azonenberg/sky130-validation/README.md

# sky130 validation stuff

Right now focusing on OpenRAM bringup chip.
