azonenberg/sky130-validation/or1/data/vmap/images/large/die4_dualport_chilled.png

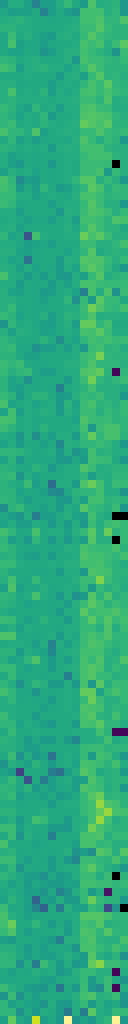
or1/data/vmap/images/large/die4_dualport_chilled.png
