azonenberg/sky130-validation/or1/data/vmap/images/large/die4_dualport_heated.png

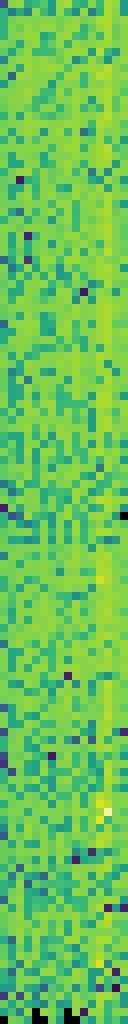
or1/data/vmap/images/large/die4_dualport_heated.png
