azonenberg/sky130-validation/or1/data/vmap/images/large/die5_dualport_ambient.png

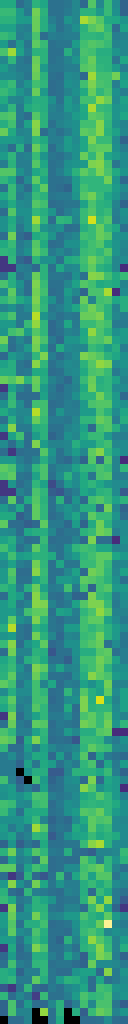
or1/data/vmap/images/large/die5_dualport_ambient.png
