azonenberg/sky130-validation/or1/data/vmap/images/large/die5_singleport_heated.png

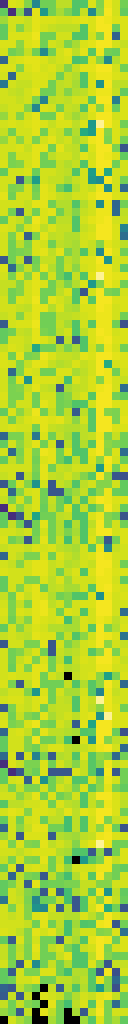
or1/data/vmap/images/large/die5_singleport_heated.png
