azonenberg/sky130-validation/or1/boards/brain/brain.kicad_pcb

## KiCad design or1/boards/brain/brain.kicad_pcb (2021-11-06)

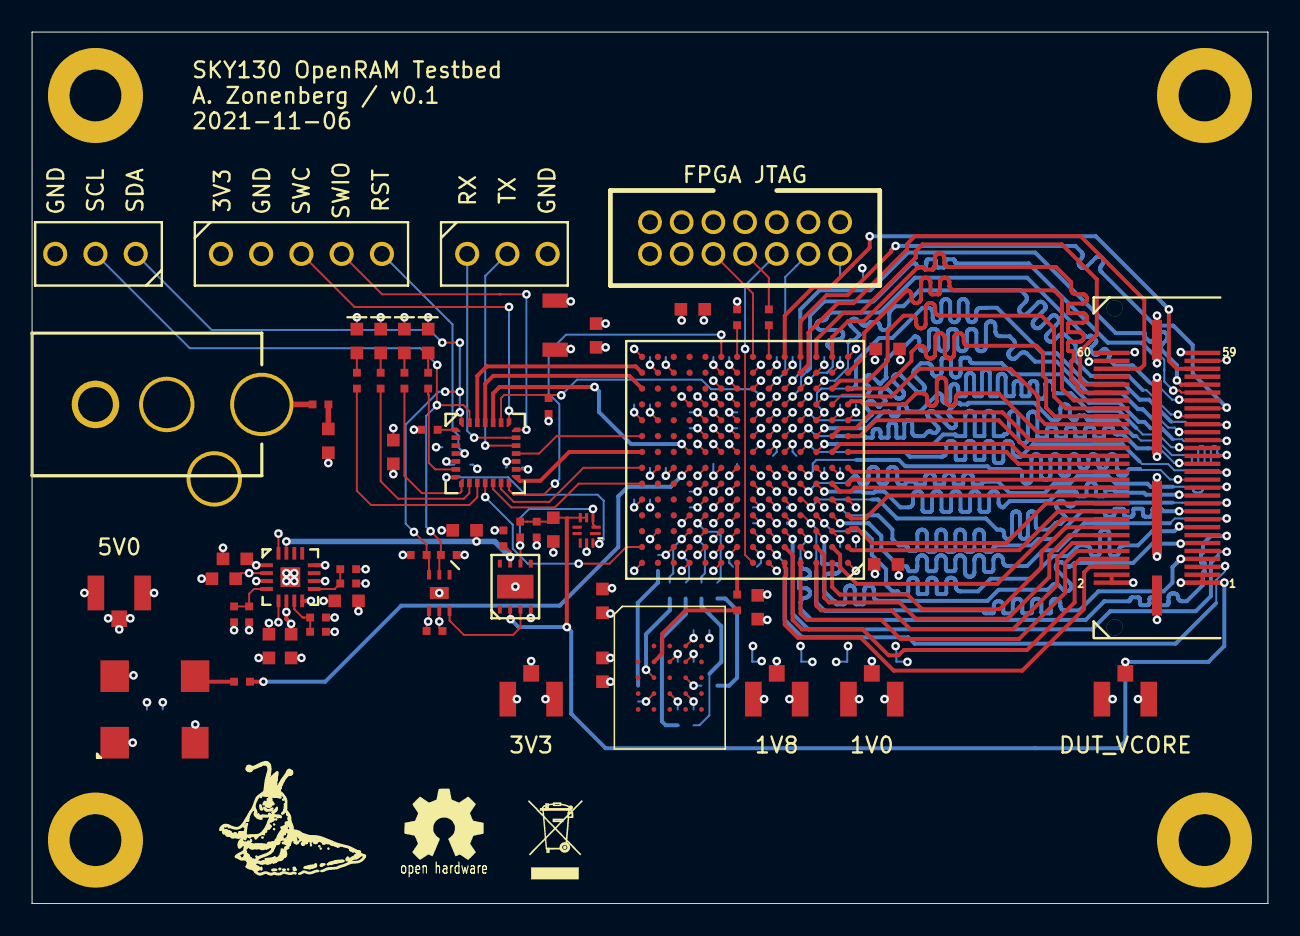
[picture p13: board brain.kicad_pcb from above]

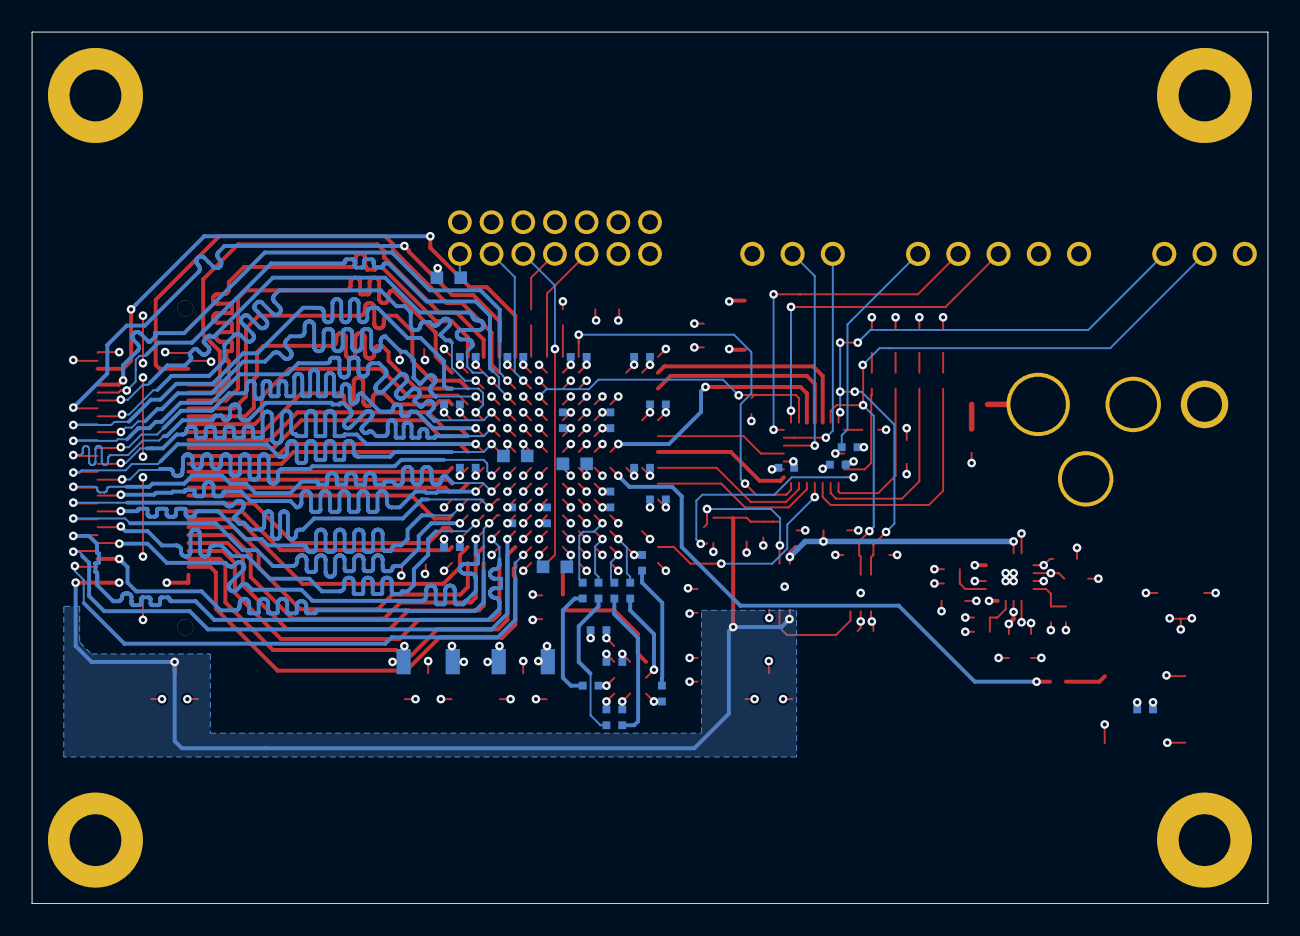
[picture p14: board brain.kicad_pcb from below]

Board: 4 copper layers, 78.0 x 55.0 mm, 103 parts (36 on the bottom side), 115 nets.

Parts:
C1, C4: 100 uF; EIA_1206_CAP_NOSILK
C2, C5, C6, C7, C9, C10, C11, C12, C13, C14, C15, C17, C18, C19, C20, C34, C37, C41, C43: 4.7 uF; EIA_0603_CAP_NOSILK
C3: 47 uF; EIA_1206_CAP_NOSILK
C8, C16, C21, C22, C23, C24, C25, C26, C27, C28, C29, C30, C31, C32, C33, C35, C36, C38, C40, C42, C44, C45: 0.47 uF; EIA_0402_CAP_NOSILK
C39: 0.1 uF; EIA_0402_CAP_NOSILK
D1, D2, D3, D4: GREEN; EIA_0603_LED
F1: 1A; EIA_0402_RES_NOSILK
FB1: 600R @ 100 MHz; EIA_0603_INDUCTOR_NOSILK
J1: XILINX_JTAG; XILINX_JTAG_PTH_MOLEX_0878311420
J2: BARREL_JACK; CONN_CUI_PJ-058BH_HIPWR_BARREL_NOSLOT
J3, J6: Conn_01x03; CONN_HEADER_2.54MM_1x3
J4: Conn_01x05; CONN_HEADER_2.54MM_1x5
J5: CONN_SKY130_TEST_HOST; CONN_SAMTEC_QSH-030-01-L-D-A
MH1, MH2, MH3, MH4: SCREWHOLE_4_40; MECHANICAL_CLEARANCEHOLE_4_40
R1, R2: 100K; EIA_0402_RES_NOSILK
R3: 130K; EIA_0402_RES_NOSILK
R4: 49.9K; EIA_0402_RES_NOSILK
R5: 187K; EIA_0402_RES_NOSILK
R6: 33K; EIA_0402_RES_NOSILK
R7, R8, R9, R10, R11, R14, R20, R21, R22, R23, R24, R29: 33; EIA_0402_RES_NOSILK
R12, R25: 10K; EIA_0402_RES_NOSILK
R13, R15, R17, R18: 1K; EIA_0402_RES_NOSILK
R16, R26, R27: 4.7k; EIA_0402_RES_NOSILK
R19: 4.7K; EIA_0402_RES_NOSILK
R28: 10 0.1%; EIA_0402_RES_NOSILK
TP1, TP2, TP3, TP4, TP5: U.FL; CONN_U.FL_TE_1909763-1
U1: STM32F031-QFN28; QFN_28_0.5MM_4x4MM_NOPAD
U2: XC7S15-1FTGB196C; BGA_196_15x15_FULLARRAY_1MM_FTGB196
U3: ADP323; QFN_16_0.5MM_3x3MM
U4: S25FL128SAGBHI300; BGA_24_6x8_DEPOP1_1MM
U5: DAC121C081-WSON; DFN_6_0.65MM_2.2x2.5MM_TI_NGF
U6: ISL24021IRT065Z-T7A‎; DFN_8_0.65MM_3x3MM
U7: INA216A2; QFN_10_0.4MM_1.4x1.8MM_TI_RSW
U8: CB3LV-3C-25M000000; OSCILLATOR_7.0x5.0

Connections:
/1V0: C1.1, C2.1, C6.1, C7.1, C8.1, C15.1, C21.1, C26.1, R1.1, TP4.1, U2.D6, U2.D8, U2.E5, U2.E7, U2.E9, U2.F6, U2.G5, U2.G9, U2.H6, U2.J5, U2.J9, U2.K6, U2.K8, U3.5
/1V8: C3.1, C9.1, C14.1, C16.1, C22.1, R3.1, TP2.1, U2.B8, U2.F8, U2.F10, U2.H10, U2.K10, U2.L9, U3.6
/3V3: C4.1, C10.1, C11.1, C12.1, C17.1, C18.1, C19.1, C20.1, C23.1, C24.1, C25.1, C27.1, C28.1, C29.1, C30.1, C31.1, C32.1, C33.1, C34.1, C35.1, C36.1, C37.1, C38.1, C40.1, C45.1, J1.2, J4.1, J5.57, J5.58, J5.59, J5.60, R5.1, R12.2, R16.1, R19.1, R26.1, R27.1, TP3.1, U1.5, U1.17, U2.B10, U2.G2, U2.G13, U2.K2, U2.K13, U2.M7, U2.N2, U2.N6, U2.N7, U2.N8, U2.N13, U3.8, U4.B4, U5.5, U8.1, U8.4
/DUT socket/ADDR0_0: J5.44, U2.M1
/DUT socket/ADDR0_1: J5.43, U2.M3
/DUT socket/ADDR0_2: J5.41, U2.K3
/DUT socket/ADDR0_3: J5.39, U2.L3
/DUT socket/ADDR0_4: J5.37, U2.K4
/DUT socket/ADDR0_5: J5.35, U2.J3
/DUT socket/ADDR0_6: J5.33, U2.J4
/DUT socket/ADDR0_7: J5.31, U2.H3
/DUT socket/ADDR1_0: J5.13, U2.C4
/DUT socket/ADDR1_1: J5.11, U2.C3
/DUT socket/ADDR1_2: J5.9, U2.C5
/DUT socket/ADDR1_3: J5.7, U2.D4
/DUT socket/ADDR1_4: J5.5, U2.B6
/DUT socket/ADDR1_5: J5.8, U2.B5
/DUT socket/ADDR1_6: J5.12, U2.A3
/DUT socket/ADDR1_7: J5.16, U2.A2
/DUT socket/CLK0: J5.45, U2.P4
/DUT socket/CLK1: J5.55, U2.P5
/DUT socket/CS0_N: J5.46, U2.M2
/DUT socket/CS1_N: J5.56, U2.N4
/DUT socket/DIN0_0: J5.40, U2.L1
/DUT socket/DIN0_1: J5.38, U2.J2
/DUT socket/DIN0_2: J5.32, U2.H1
/DUT socket/DIN0_3: J5.30, U2.G1
/DUT socket/DIN0_4: J5.26, U2.F2
/DUT socket/DIN0_5: J5.22, U2.C1
/DUT socket/DIN0_6: J5.18, U2.B2
/DUT socket/DIN0_7: J5.10, U2.A4
/DUT socket/DOUT0_0: J5.36, U2.J1
/DUT socket/DOUT0_1: J5.42, U2.L2
/DUT socket/DOUT0_2: J5.34, U2.H2
/DUT socket/DOUT0_3: J5.28, U2.F1
/DUT socket/DOUT0_4: J5.24, U2.D1
/DUT socket/DOUT0_5: J5.20, U2.B1
/DUT socket/DOUT0_6: J5.14, U2.B3
/DUT socket/DOUT0_7: J5.6, U2.A5
/DUT socket/DOUT1_0: J5.15, U2.D3
/DUT socket/DOUT1_1: J5.27, U2.G4
/DUT socket/DOUT1_2: J5.29, U2.H4
/DUT socket/DOUT1_3: J5.17, U2.D2
/DUT socket/DOUT1_4: J5.19, U2.E2
/DUT socket/DOUT1_5: J5.21, U2.E4
/DUT socket/DOUT1_6: J5.23, U2.F3
/DUT socket/DOUT1_7: J5.25, U2.F4
/DUT socket/GPIO0: J5.52, U2.P3
/DUT socket/WE0_N: J5.50, U2.P2
/DUT socket/WMASK0_0: J5.51, U2.M5
/DUT socket/WMASK0_1: J5.49, U2.L5
/DUT socket/WMASK0_2: J5.47, U2.M4
/DUT socket/WMASK0_3: J5.48, U2.N1
/DUT_VCORE: C43.1, C44.1, J5.1, J5.2, J5.3, J5.4, R28.1, TP5.1, U6.2, U7.4, U7.5
/DUT_VDD_ISENSE: U1.7, U7.10
/FLASH_CS_N: R11.2, U4.C2
/FLASH_DQ0: R7.2, R21.1
/FLASH_DQ1: R8.2, R22.1
/FLASH_DQ2: R9.2, R23.1
/FLASH_DQ3: R10.2, R24.1
/FLASH_RST_N: R12.1, U4.A4
/FLASH_SCK: R20.1, U4.B2
/FPGA_CLK_25MHZ: R29.1, U2.G11
/FPGA_DONE: U1.14, U2.P9
/FPGA_RST_N: R16.2, U1.23, U2.L7
/GND: C1.2, C2.2, C3.2, C4.2, C5.2, C6.2, C7.2, C8.2, C9.2, C10.2, C11.2, C12.2, C13.2, C14.2, C15.2, C16.2, C17.2, C18.2, C19.2, C20.2, C21.2, C22.2, C23.2, C24.2, C25.2, C26.2, C27.2, C28.2, C29.2, C30.2, C31.2, C32.2, C33.2, C34.2, C35.2, C36.2, C37.2, C38.2, C39.2, C40.2, C41.2, C42.2, C43.2, C44.2, C45.2, D1.1, D2.1, D3.1, D4.1, J1.3, J1.5, J1.7, J1.9, J1.11, J2.2, J3.3, J4.2, J5.GND, J6.3, R2.1, R4.1, R6.1, R25.2, TP1.2, TP2.2, TP3.2, TP4.2, TP5.2, U1.16, U2.A1, U2.A6, U2.A9, U2.A11, U2.A14, U2.B4, U2.B7, U2.B9, U2.C2, U2.C6, U2.C7, U2.C8, U2.C9, U2.C13, U2.D5, U2.D7, U2.D9, U2.D11, U2.E1, U2.E3, U2.E6, U2.E8, U2.E10, U2.E14, U2.F5, U2.F7, U2.F9, U2.G3, U2.G6, U2.G7, U2.G8, U2.G10, U2.G12, U2.H5, U2.H7, U2.H8, U2.H9, U2.J6, U2.J7, U2.J8, U2.J10, U2.K1, U2.K5, U2.K7, U2.K9, U2.K14, U2.L4, U2.L6, U2.L8, U2.L10, U2.L11, U2.M8, U2.M9, U2.N3, U2.N5, U2.N9, U2.N12, U2.P1, U2.P14, U3.12, U3.PAD, U4.B3, U5.4, U5.PAD, U6.4, U6.PAD, U7.9, U8.2
/I2C_SCL: J6.2, R26.2, U1.27, U5.2
/I2C_SDA: J6.1, R27.2, U1.28, U5.3
/JTAG_TCK: J1.6, U2.A7
/JTAG_TDI: J1.10, U2.P7
/JTAG_TDO: J1.8, R14.2
/JTAG_TMS: J1.4, U2.M6
/MCU_GPIO0: U1.12, U2.F14
/MCU_GPIO1: U1.13, U2.G14
/MCU_GPIO2: U1.18, U2.J14
/MCU_GPIO3: U1.11, U2.B14
/MCU_LED0: R13.2, U1.10
/MCU_LED1: R15.2, U1.9
/MCU_LED2: R17.2, U1.8
/MCU_LED3: R18.2, U1.6
/MCU_RST_N: C39.1, J4.5, U1.4
/MCU_SPI_CS_N: U1.15, U2.H14
/MCU_SPI_SCK: U1.24, U2.H11
/MCU_SPI_SI: U1.26, U2.N14
/MCU_SPI_SO: U1.25, U2.M14
/Power supply/5V0: C5.1, C13.1, C41.1, C42.1, FB1.2, TP1.1, U3.1, U3.2, U3.3, U3.10, U3.15, U3.16, U6.7
/Power supply/DAC_VOUT: U5.6, U6.3
/Power supply/DUT_VDD_RAW: R28.2, U6.6, U7.2, U7.3
/Power supply/MCU_BOOT0: R25.1, U1.1
/SWCLK: J4.3, U1.22
/SWDIO: J4.4, U1.21
/UART_RX: J3.1, U1.20
/UART_TX: J3.2, U1.19
unnamed: D1.2, R13.1
unnamed: D2.2, R15.1
unnamed: D3.2, R17.1
unnamed: D4.2, R18.1
unnamed: F1.1, J2.1
unnamed: F1.2, FB1.1
unnamed: R1.2, R2.2, U3.4
unnamed: R3.2, R4.2, U3.7
unnamed: R5.2, R6.2, U3.9
unnamed: R7.1, U2.B11
unnamed: R8.1, U2.B12
unnamed: R9.1, U2.D10
unnamed: R10.1, U2.C10
unnamed: R11.1, U2.C11
unnamed: R14.1, U2.P6
unnamed: R19.2, U2.P8
unnamed: R20.2, U2.A8
unnamed: R21.2, U4.D3
unnamed: R22.2, U4.D2
unnamed: R23.2, U4.C4
unnamed: R24.2, U4.D4
unnamed: R29.2, U8.3
