azonenberg/sky130-validation/or1/boards/breakout/breakout.kicad_pcb

## KiCad design or1/boards/breakout/breakout.kicad_pcb (2021-11-06)

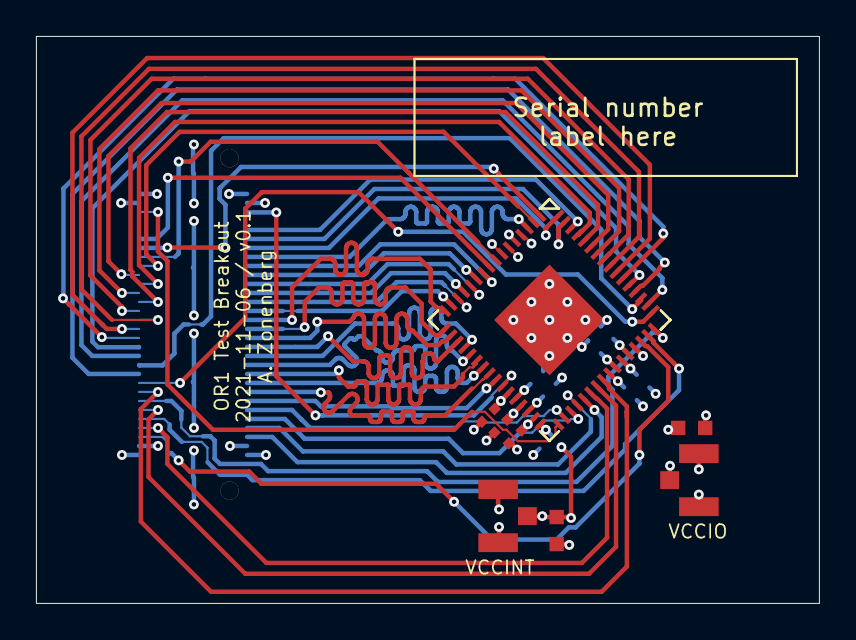
[picture p15: board breakout.kicad_pcb from above]

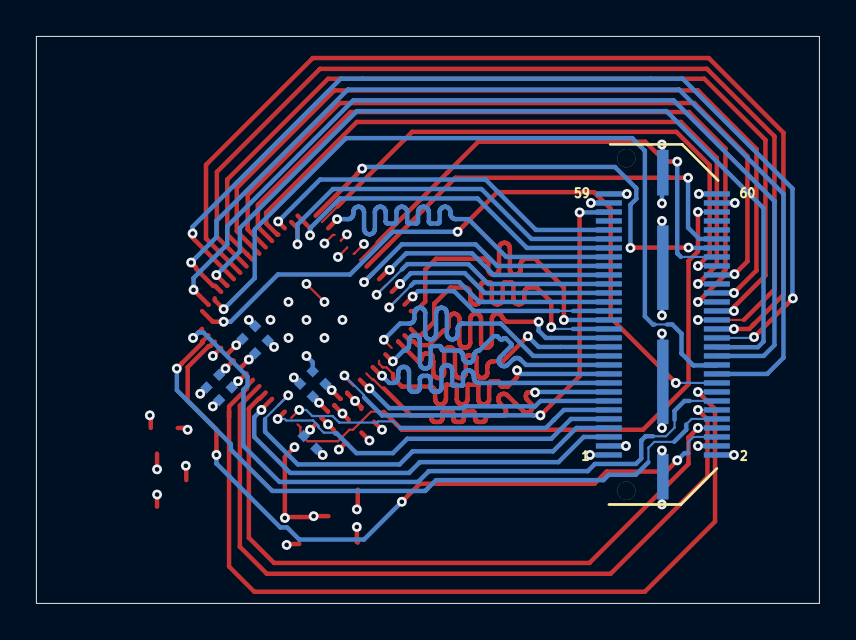
[picture p16: board breakout.kicad_pcb from below]

Board: 4 copper layers, 43.5 x 31.5 mm, 16 parts (8 on the bottom side), 52 nets.

Parts:
C1, C2: 4.7 uF; EIA_0603_CAP_NOSILK
C3, C4, C5, C6, C7, C8, C9, C10, C11, C12: 0.47 uF; EIA_0402_CAP_NOSILK
J1: CONN_SKY130_TEST_DEVICE; CONN_SAMTEC_QTH-030-01-L-D-A
TP1, TP2: U.FL; CONN_U.FL_TE_1909763-1
U1: SKY130_TEST_OR1; QFN_64_0.5MM_9x9MM

Connections:
/ADDR0[0]: J1.44, U1.2
/ADDR0[1]: J1.43, U1.10
/ADDR0[2]: J1.41, U1.11
/ADDR0[3]: J1.39, U1.12
/ADDR0[4]: J1.37, U1.13
/ADDR0[5]: J1.35, U1.14
/ADDR0[6]: J1.33, U1.15
/ADDR0[7]: J1.31, U1.16
/ADDR1[0]: J1.13, U1.25
/ADDR1[1]: J1.11, U1.34
/ADDR1[2]: J1.9, U1.35
/ADDR1[3]: J1.7, U1.36
/ADDR1[4]: J1.5, U1.37
/ADDR1[5]: J1.8, U1.38
/ADDR1[6]: J1.12, U1.39
/ADDR1[7]: J1.16, U1.40
/CLK0: J1.45, U1.3
/CLK1: J1.55, U1.26
/CS0_N: J1.46, U1.8
/CS1_N: J1.56, U1.33
/DIN0[0]: J1.40, U1.61
/DIN0[7]: J1.38, U1.58
/DIN0[8]: J1.32, U1.56
/DIN0[15]: J1.30, U1.55
/DIN0[16]: J1.26, U1.53
/DIN0[23]: J1.22, U1.51
/DIN0[24]: J1.18, U1.49
/DIN0[31]: J1.10, U1.47
/DOUT0[0]: J1.36, U1.60
/DOUT0[7]: J1.42, U1.59
/DOUT0[8]: J1.34, U1.57
/DOUT0[15]: J1.28, U1.54
/DOUT0[16]: J1.20, U1.52
/DOUT0[23]: J1.24, U1.50
/DOUT0[24]: J1.14, U1.48
/DOUT0[31]: J1.6, U1.46
/DOUT1[0]: J1.15, U1.24
/DOUT1[7]: J1.27, U1.18
/DOUT1[8]: J1.29, U1.17
/DOUT1[15]: J1.17, U1.23
/DOUT1[16]: J1.19, U1.22
/DOUT1[23]: J1.21, U1.21
/DOUT1[24]: J1.23, U1.20
/DOUT1[31]: J1.25, U1.19
/GND: C1.2, C2.2, C3.2, C4.2, C5.2, C6.2, C7.2, C8.2, C9.2, C10.2, C11.2, C12.2, J1.GND, TP1.2, TP2.2, U1.4, U1.5, U1.6, U1.7, U1.45, U1.PAD
/VCCINT: C2.1, C4.1, C6.1, C8.1, C10.1, C12.1, J1.1, J1.2, J1.3, J1.4, TP2.1, U1.28, U1.29, U1.30, U1.31, U1.32
/VCCIO: C1.1, C3.1, C5.1, C7.1, C9.1, C11.1, J1.57, J1.58, J1.59, J1.60, TP1.1, U1.27, U1.41, U1.42, U1.43, U1.44
/WE0_N: J1.50, U1.9
/WMASK0[0]: J1.51, U1.62
/WMASK0[1]: J1.49, U1.63
/WMASK0[2]: J1.47, U1.64
/WMASK0[3]: J1.48, U1.1
