azonenberg/sky130-validation/or1/firmware/fpga/memtest.srcs/constrs_1/new/top.xdc

set_property IOSTANDARD LVCMOS33 [get_ports {addr0[7]}]
set_property IOSTANDARD LVCMOS33 [get_ports {addr0[6]}]
set_property IOSTANDARD LVCMOS33 [get_ports {addr0[5]}]
set_property IOSTANDARD LVCMOS33 [get_ports {addr0[4]}]
set_property IOSTANDARD LVCMOS33 [get_ports {addr0[3]}]
set_property IOSTANDARD LVCMOS33 [get_ports {addr0[2]}]
set_property IOSTANDARD LVCMOS33 [get_ports {addr0[1]}]
set_property IOSTANDARD LVCMOS33 [get_ports {addr0[0]}]
set_property IOSTANDARD LVCMOS33 [get_ports {addr1[7]}]
set_property IOSTANDARD LVCMOS33 [get_ports {addr1[6]}]
set_property IOSTANDARD LVCMOS33 [get_ports {addr1[5]}]
set_property IOSTANDARD LVCMOS33 [get_ports {addr1[4]}]
set_property IOSTANDARD LVCMOS33 [get_ports {addr1[3]}]
set_property IOSTANDARD LVCMOS33 [get_ports {addr1[2]}]
set_property IOSTANDARD LVCMOS33 [get_ports {addr1[1]}]
set_property IOSTANDARD LVCMOS33 [get_ports {addr1[0]}]
set_property IOSTANDARD LVCMOS33 [get_ports {flash_dq[3]}]
set_property IOSTANDARD LVCMOS33 [get_ports {flash_dq[2]}]
set_property IOSTANDARD LVCMOS33 [get_ports {flash_dq[1]}]
set_property IOSTANDARD LVCMOS33 [get_ports {flash_dq[0]}]
set_property IOSTANDARD LVCMOS33 [get_ports {mcu_gpio[3]}]
set_property IOSTANDARD LVCMOS33 [get_ports {mcu_gpio[2]}]
set_property IOSTANDARD LVCMOS33 [get_ports {mcu_gpio[1]}]
set_property IOSTANDARD LVCMOS33 [get_ports {mcu_gpio[0]}]
set_property IOSTANDARD LVCMOS33 [get_ports {rdata0[7]}]
set_property IOSTANDARD LVCMOS33 [get_ports {rdata0[6]}]
set_property IOSTANDARD LVCMOS33 [get_ports {rdata0[5]}]
set_property IOSTANDARD LVCMOS33 [get_ports {rdata0[4]}]
set_property IOSTANDARD LVCMOS33 [get_ports {rdata0[3]}]
set_property IOSTANDARD LVCMOS33 [get_ports {rdata0[2]}]
set_property IOSTANDARD LVCMOS33 [get_ports {rdata0[1]}]
set_property IOSTANDARD LVCMOS33 [get_ports {rdata0[0]}]
set_property IOSTANDARD LVCMOS33 [get_ports {rdata1[7]}]
set_property IOSTANDARD LVCMOS33 [get_ports {rdata1[6]}]
set_property IOSTANDARD LVCMOS33 [get_ports {rdata1[5]}]
set_property IOSTANDARD LVCMOS33 [get_ports {rdata1[4]}]
set_property IOSTANDARD LVCMOS33 [get_ports {rdata1[3]}]
set_property IOSTANDARD LVCMOS33 [get_ports {rdata1[2]}]
set_property IOSTANDARD LVCMOS33 [get_ports {rdata1[1]}]
set_property IOSTANDARD LVCMOS33 [get_ports {rdata1[0]}]
set_property IOSTANDARD LVCMOS33 [get_ports {wdata0[7]}]
set_property IOSTANDARD LVCMOS33 [get_ports {wdata0[6]}]
set_property IOSTANDARD LVCMOS33 [get_ports {wdata0[5]}]
set_property IOSTANDARD LVCMOS33 [get_ports {wdata0[4]}]
set_property IOSTANDARD LVCMOS33 [get_ports {wdata0[3]}]
set_property IOSTANDARD LVCMOS33 [get_ports {wdata0[2]}]
set_property IOSTANDARD LVCMOS33 [get_ports {wdata0[1]}]
set_property IOSTANDARD LVCMOS33 [get_ports {wdata0[0]}]
set_property IOSTANDARD LVCMOS33 [get_ports {wmask0[3]}]
set_property IOSTANDARD LVCMOS33 [get_ports {wmask0[2]}]
set_property IOSTANDARD LVCMOS33 [get_ports {wmask0[1]}]
set_property IOSTANDARD LVCMOS33 [get_ports {wmask0[0]}]
set_property IOSTANDARD LVCMOS33 [get_ports clk0]
set_property IOSTANDARD LVCMOS33 [get_ports clk1]
set_property IOSTANDARD LVCMOS33 [get_ports clk_25mhz]
set_property IOSTANDARD LVCMOS33 [get_ports cs0_n]
set_property IOSTANDARD LVCMOS33 [get_ports dut_gpio0]
set_property IOSTANDARD LVCMOS33 [get_ports cs1_n]
set_property IOSTANDARD LVCMOS33 [get_ports flash_cs_n]
set_property IOSTANDARD LVCMOS33 [get_ports mcu_spi_cs_n]
set_property IOSTANDARD LVCMOS33 [get_ports mcu_spi_sck]
set_property IOSTANDARD LVCMOS33 [get_ports mcu_spi_si]
set_property IOSTANDARD LVCMOS33 [get_ports mcu_spi_so]
set_property IOSTANDARD LVCMOS33 [get_ports we0_n]
set_property PACKAGE_PIN C3 [get_ports {addr1[1]}]
set_property PACKAGE_PIN A3 [get_ports {addr1[6]}]
set_property PACKAGE_PIN B5 [get_ports {addr1[5]}]
set_property PACKAGE_PIN C5 [get_ports {addr1[2]}]
set_property PACKAGE_PIN D4 [get_ports {addr1[3]}]
set_property PACKAGE_PIN B6 [get_ports {addr1[4]}]
set_property PACKAGE_PIN A2 [get_ports {addr1[7]}]
set_property PACKAGE_PIN C4 [get_ports {addr1[0]}]
set_property PACKAGE_PIN H3 [get_ports {addr0[7]}]
set_property PACKAGE_PIN J4 [get_ports {addr0[6]}]
set_property PACKAGE_PIN J3 [get_ports {addr0[5]}]
set_property PACKAGE_PIN K4 [get_ports {addr0[4]}]
set_property PACKAGE_PIN L3 [get_ports {addr0[3]}]
set_property PACKAGE_PIN K3 [get_ports {addr0[2]}]
set_property PACKAGE_PIN M3 [get_ports {addr0[1]}]
set_property PACKAGE_PIN M1 [get_ports {addr0[0]}]
set_property PACKAGE_PIN C10 [get_ports {flash_dq[3]}]
set_property PACKAGE_PIN D10 [get_ports {flash_dq[2]}]
set_property PACKAGE_PIN B12 [get_ports {flash_dq[1]}]
set_property PACKAGE_PIN B11 [get_ports {flash_dq[0]}]
set_property PACKAGE_PIN B14 [get_ports {mcu_gpio[3]}]
set_property PACKAGE_PIN J14 [get_ports {mcu_gpio[2]}]
set_property PACKAGE_PIN G14 [get_ports {mcu_gpio[1]}]
set_property PACKAGE_PIN F14 [get_ports {mcu_gpio[0]}]
set_property PACKAGE_PIN A5 [get_ports {rdata0[7]}]
set_property PACKAGE_PIN B3 [get_ports {rdata0[6]}]
set_property PACKAGE_PIN D1 [get_ports {rdata0[5]}]
set_property PACKAGE_PIN B1 [get_ports {rdata0[4]}]
set_property PACKAGE_PIN F1 [get_ports {rdata0[3]}]
set_property PACKAGE_PIN H2 [get_ports {rdata0[2]}]
set_property PACKAGE_PIN L2 [get_ports {rdata0[1]}]
set_property PACKAGE_PIN J1 [get_ports {rdata0[0]}]
set_property PACKAGE_PIN F4 [get_ports {rdata1[7]}]
set_property PACKAGE_PIN F3 [get_ports {rdata1[6]}]
set_property PACKAGE_PIN E4 [get_ports {rdata1[5]}]
set_property PACKAGE_PIN E2 [get_ports {rdata1[4]}]
set_property PACKAGE_PIN D2 [get_ports {rdata1[3]}]
set_property PACKAGE_PIN H4 [get_ports {rdata1[2]}]
set_property PACKAGE_PIN G4 [get_ports {rdata1[1]}]
set_property PACKAGE_PIN D3 [get_ports {rdata1[0]}]
set_property PACKAGE_PIN A4 [get_ports {wdata0[7]}]
set_property PACKAGE_PIN B2 [get_ports {wdata0[6]}]
set_property PACKAGE_PIN C1 [get_ports {wdata0[5]}]
set_property PACKAGE_PIN F2 [get_ports {wdata0[4]}]
set_property PACKAGE_PIN G1 [get_ports {wdata0[3]}]
set_property PACKAGE_PIN H1 [get_ports {wdata0[2]}]
set_property PACKAGE_PIN J2 [get_ports {wdata0[1]}]
set_property PACKAGE_PIN L1 [get_ports {wdata0[0]}]
set_property PACKAGE_PIN N1 [get_ports {wmask0[3]}]
set_property PACKAGE_PIN M4 [get_ports {wmask0[2]}]
set_property PACKAGE_PIN L5 [get_ports {wmask0[1]}]
set_property PACKAGE_PIN M5 [get_ports {wmask0[0]}]
set_property PACKAGE_PIN P4 [get_ports clk0]
set_property PACKAGE_PIN P5 [get_ports clk1]
set_property PACKAGE_PIN M2 [get_ports cs0_n]
set_property PACKAGE_PIN N4 [get_ports cs1_n]
set_property PACKAGE_PIN P3 [get_ports dut_gpio0]
set_property PACKAGE_PIN P2 [get_ports we0_n]
set_property PACKAGE_PIN G11 [get_ports clk_25mhz]
set_property PACKAGE_PIN C11 [get_ports flash_cs_n]
set_property PACKAGE_PIN H14 [get_ports mcu_spi_cs_n]
set_property PACKAGE_PIN H11 [get_ports mcu_spi_sck]
set_property PACKAGE_PIN N14 [get_ports mcu_spi_si]
set_property PACKAGE_PIN M14 [get_ports mcu_spi_so]

create_clock -period 40.000 -name clk_25mhz -waveform {0.000 20.000} [get_ports clk_25mhz]
