azonenberg/sky130-validation/(commit log)

2021-06-23 Initial version of schematic ready for design review
    [brain.kicad_pcb, brain.sch, dut.sch, psu.sch]
2021-08-08 Continued initial work on brain board
    [brain.kicad_pcb, brain.sch, dut.sch, psu.sch]
2021-08-08 Updated brain board with silkscreen logos and mounting holes
    [brain.kicad_pcb, brain.sch, dut.sch]
2021-08-15 Initial version of breakout
    [breakout.kicad_pcb, breakout.sch]
2021-11-05 Finished initial routing. Ready for layout review.
    [brain.kicad_pcb, brain.sch, breakout.kicad_pcb, breakout.sch, dut.sch, psu.sch, trace-lengths.ods]
2021-11-06 Final rev of breakout ready for fab
    [breakout.kicad_pcb, breakout.sch, trace-lengths.ods]
2021-11-06 Final rev of brain after layout review
    [brain.kicad_pcb, brain.sch, dut.sch, psu.sch]
2021-11-22 Added CLI session and interrupt vector file missed in last commit
    [BringupCLISessionContext.cpp, BringupCLISessionContext.h, bringup.h, vectors.cpp]
2021-12-09 MemoryTester now gives correct, expected results on both ports for a single PRBS test on one die
    [MemoryTester.sv]
2021-12-28 Initial characterization data
    [die1-merged.csv, die1-merged.ods, die1.csv]
2022-01-01 Uploading characterization data to date
    [die1-combined.ods, die1-dualport.ods, die1-singleport.ods, die1.csv, die1_dualport_ambient.ods, die1_singleport_ambient.ods]
2022-01-01 Added die 1 fvshmoo characterization data
    [die1-summary.csv, die1-summary.ods, die1.csv]
2022-01-01 Fixed bug in summarization script
    [die1-summary.csv, die1-summary.ods]
2022-01-02 Fixed typo in log messages
    [BringupCLISessionContext.cpp]
2022-01-02 Added static phase delay to fvshmoo to compensate for PCB trace delays
2022-01-02 Added fpshmoo
    [die1-summary.ods, die1.csv, die1_singleport_ambient.ods, die1_summary.csv]
2022-01-02 Removed out of date spreadsheets
    [die1_dualport_ambient.ods, die1_singleport_ambient.ods]
2022-01-02 New test results from fvshmoo with optimized read capture delay
    [die1.csv]
2022-01-02 Added die 1 summary with new timing
    [die1-summary.csv, die1-summary.ods]
2022-01-02 Added test data from dies 2 and 3
    [die2-summary.csv, die2-summary.ods, die2.csv, die3-summary.csv, die3-summary.ods, die3.csv]
2022-01-07 Added vmap test results on die 1
    [die1.csv, die1_dualport_ambient_rearranged.csv, die1_singleport_ambient_rearranged.csv]
2022-01-07 Added data from die 2 vmap, rearranged some stuff
    [die1_dualport_ambient_rearranged.csv, die1_singleport_ambient_rearranged.csv, die2.csv, die2_dualport_ambient_rearranged.csv, die2_singleport_ambient_rearranged.csv]
2022-01-08 Added die 3 vmap analysis
    [die3_dualport_ambient_rearranged.csv, die3_singleport_ambient_rearranged.csv, die3_singleport_ambient_rearranged.ods]
2022-01-08 Added die 3 vmap raw data
    [die3.csv]
2022-01-08 Added source and data for rwshmoo test
    [die1.csv, die1_ambient.ods, die2.csv, die2_ambient.ods, die3.csv, die3_ambient.ods]
2022-01-09 Updated characterization data for rwshmoo test with bug fixes on FPGA side
    [die1.csv, die1_ambient.ods, die2.csv, die2_ambient.ods, die3.csv, die3_ambient.ods]
2022-01-09 Removed operating voltage test results as they're redundant (duplicated by shmoo plots)
    [die1-combined.ods, die1-dualport.ods, die1-singleport.ods, die1.csv]
2022-01-09 Added characterization data from die 5
    [die5.csv]
2022-01-09 Added more characterization data from die 5
    [die5.csv]
2022-01-10 Added characterization data from die 4
    [die4.csv]
2022-01-10 Added die 3 characterization data
    [die3.csv]
2022-01-10 Unified frequency/sampling delay time for everything. Updated CLI library with bug fix.
    [BringupCLISessionContext.cpp]
2022-01-10 Added characterization data from die 2
    [die2.csv]
2022-01-10 Added some missing test data
    [die3.csv, die4.csv, die5.csv]
2022-01-10 Added characterization data from die 1
    [die1.csv]
2022-01-11 Added analysis for fpshmoo
    [die1-summary.ods, die1_singleport_ambient.ods, die1_summary.csv, die2-summary.ods, die2_summary.csv, die3-summary.ods, die3_summary.csv, die4-summary.ods]
2022-01-11 Added die 5 single port heated plot
    [die5-singleport-heated.ods]
2022-01-11 Added fvshmoo analysis
    [die1-summary.csv, die1-summary.ods, die2-summary.csv, die2-summary.ods, die3-summary.csv, die3-summary.ods, die4-summary.csv, die4-summary.ods]
2022-01-11 Added retention analysis
    [die1-merged.csv, die1-merged.ods, die2-merged.ods, die3-merged.ods, die4-merged.ods, die5-merged.ods]
2022-01-11 Added rwshmoo analysis
    [die1-summary.ods, die1_ambient.ods, die1_summary.csv, die2-summary.ods, die2_ambient.ods, die2_summary.csv, die3-summary.ods, die3_ambient.ods]
2022-01-11 Added rearranged vmap data
    [die1_dualport_ambient.csv, die1_dualport_ambient_rearranged.csv, die1_dualport_chilled.csv, die1_dualport_heated.csv, die1_singleport_ambient.csv, die1_singleport_ambient_rearranged.csv, die1_singleport_chilled.csv, die1_singleport_heated.csv]
